tofijak/kestrel/docs/img/adapter_iPhone15_scope_side.png

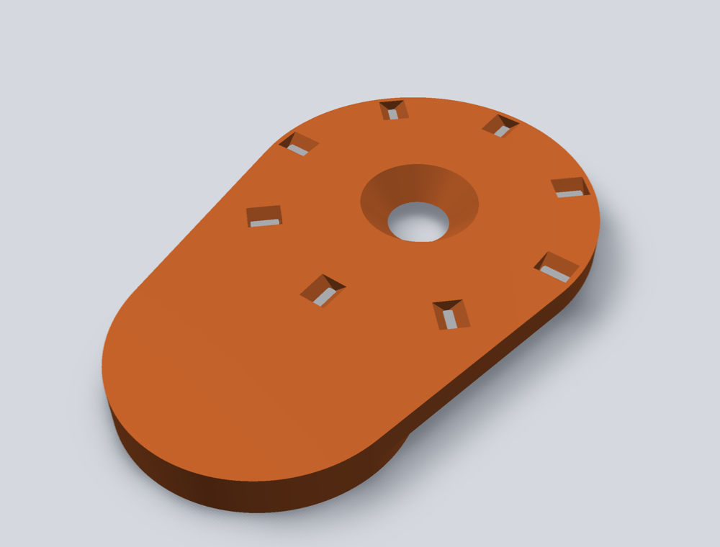
docs/img/adapter_iPhone15_scope_side.png
