tofijak/kestrel/preview.png

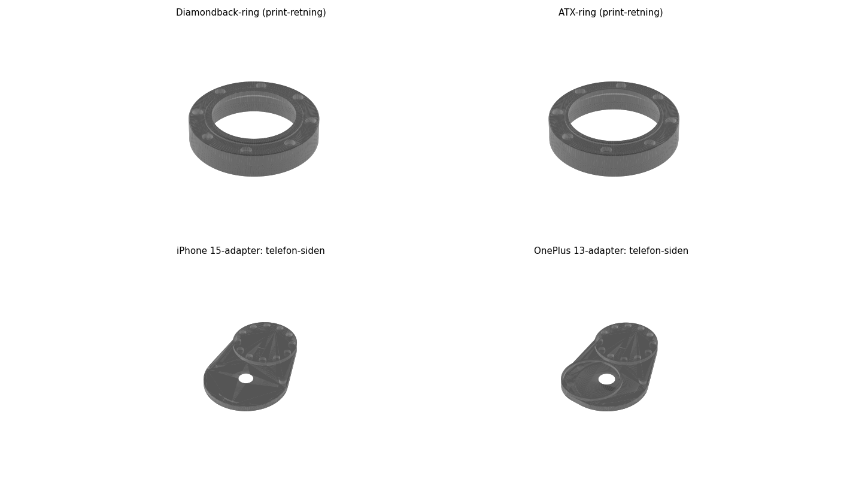
preview.png
