tofijak/kestrel/samling_OP13_preview.png

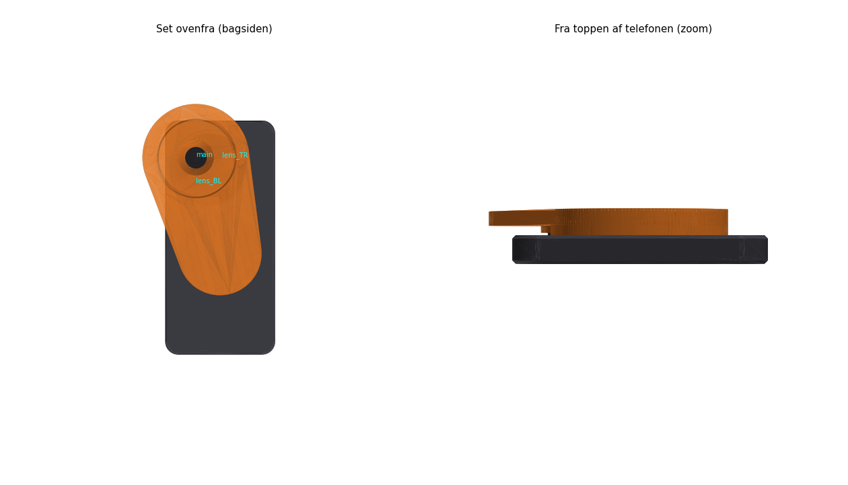
samling_OP13_preview.png
