tofijak/kestrel/print/PLA_Diamondback_iPhone15.3mf

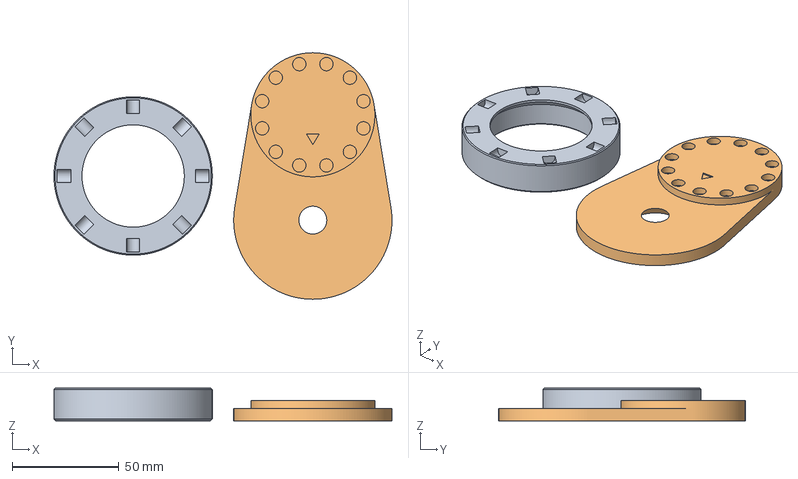
[picture p14: CAD file, 2026-11-11]
print/PLA_Diamondback_iPhone15.3mf
158.0 x 115.2 x 15.2 mm
okular_ring_DiamondbackHD85
telefon_adapter_iPhone15
