tofijak/kestrel/telefon_adapter_OP13.stl

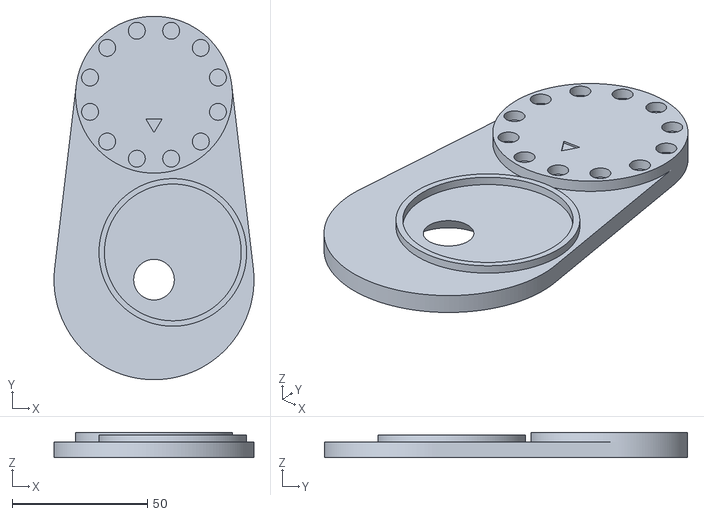
[picture p15: CAD file, 2026-11-11]
telefon_adapter_OP13.stl
74.0 x 134.4 x 9.30
