tofijak/kestrel/print/PETG_test_kobling.3mf

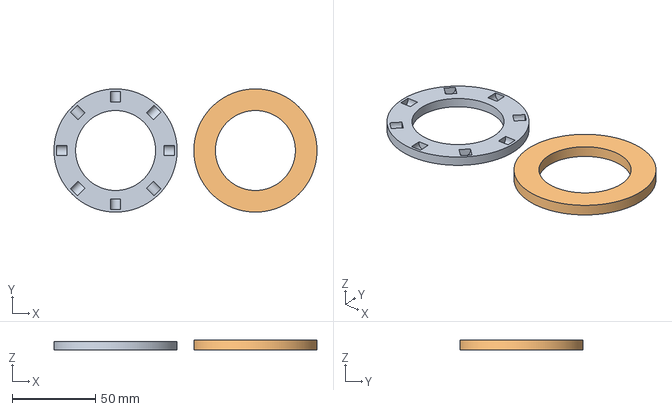
[picture p16: CAD file, 2026-11-11]
print/PETG_test_kobling.3mf
158.0 x 74.0 x 5.80 mm
test_ring
test_adapter
