tofijak/kestrel/test_ring.stl

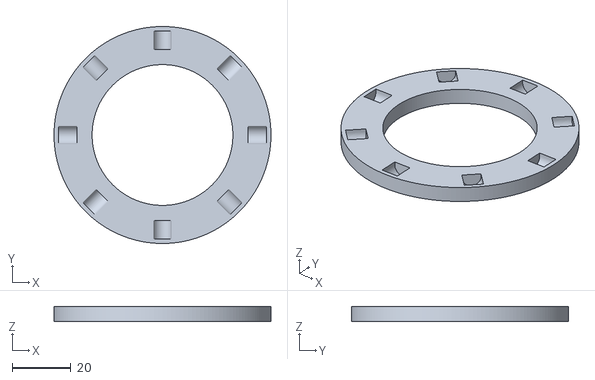
[picture p17: CAD file, 2026-11-11]
test_ring.stl
74.0 x 74.0 x 5.00
