tofijak/kestrel/okular_ring_ATX.stl

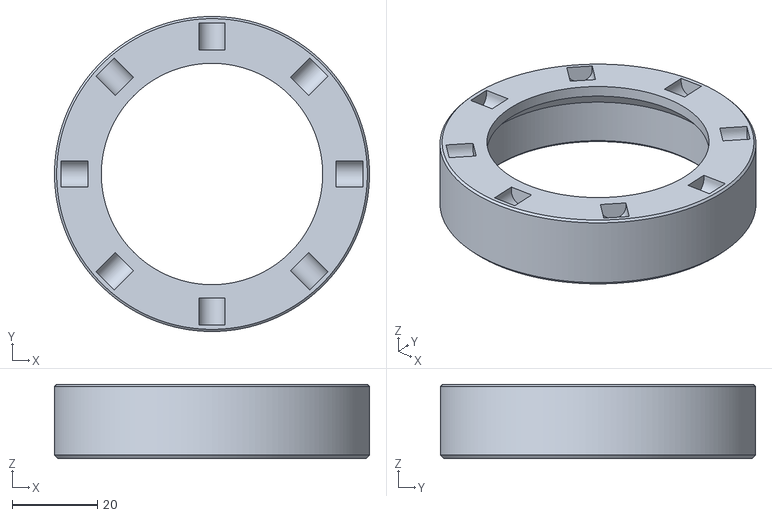
[picture p18: CAD file, 2026-11-11]
okular_ring_ATX.stl
74.0 x 74.0 x 17.5
