tofijak/kestrel/print/PLA_ATX_OnePlus13.3mf

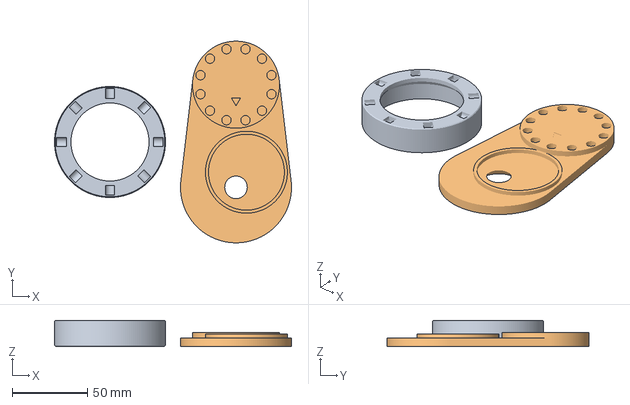
[picture p19: CAD file, 2026-11-11]
print/PLA_ATX_OnePlus13.3mf
158.0 x 134.4 x 17.5 mm
okular_ring_ATX
telefon_adapter_OP13
