tofijak/kestrel/test_adapter.stl

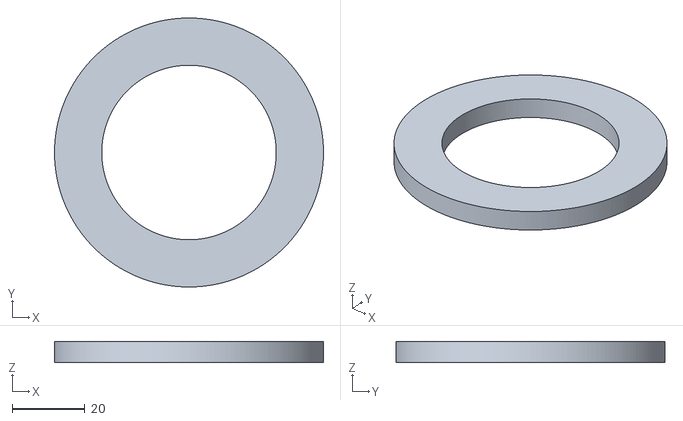
[picture p20: CAD file, 2026-11-11]
test_adapter.stl
74.0 x 74.0 x 5.80
