tofijak/kestrel/telefon_adapter_iPhone15.stl

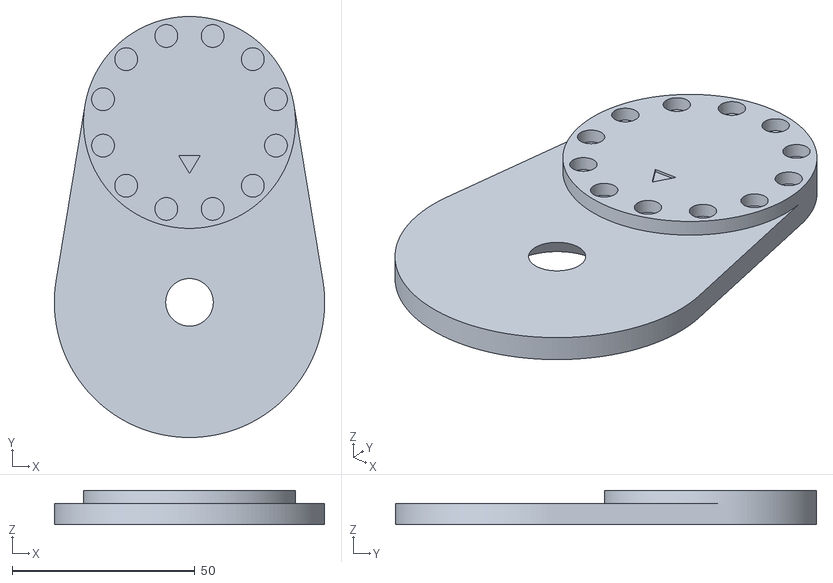
[picture p21: CAD file, 2026-11-11]
telefon_adapter_iPhone15.stl
74.0 x 115.2 x 9.40
