tofijak/kestrel/okular_ring_DiamondbackHD85.stl

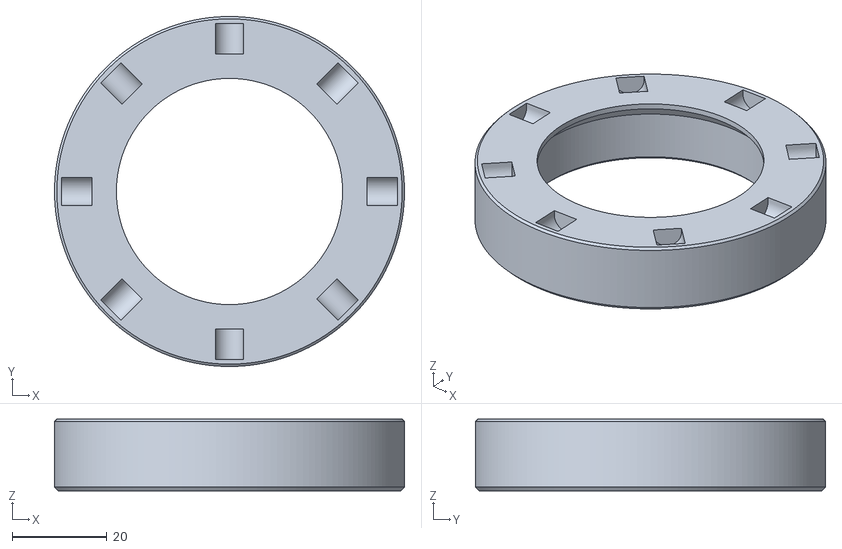
[picture p22: CAD file, 2026-11-11]
okular_ring_DiamondbackHD85.stl
74.0 x 74.0 x 15.2
