tofijak/kestrel/samling_OP13_adapter.stl

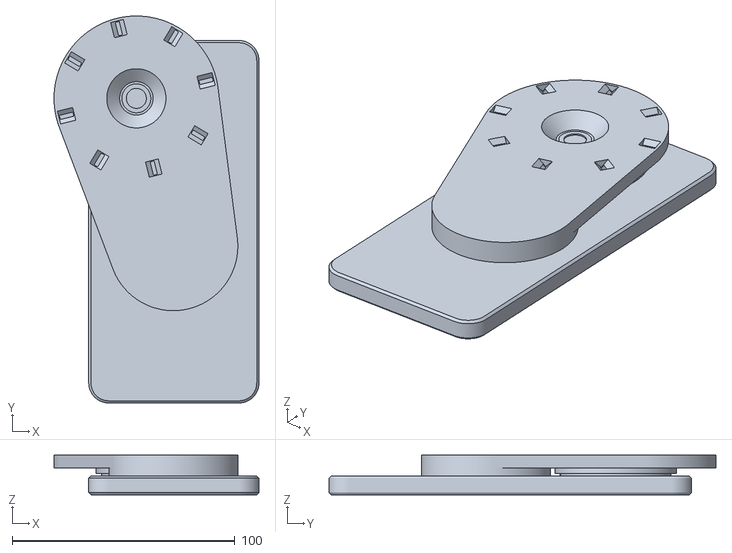
[picture p23: CAD file, 2026-11-11]
samling_OP13_adapter.stl
92.1 x 173.9 x 17.8
