tofijak/kestrel/oneplus13_model.stl

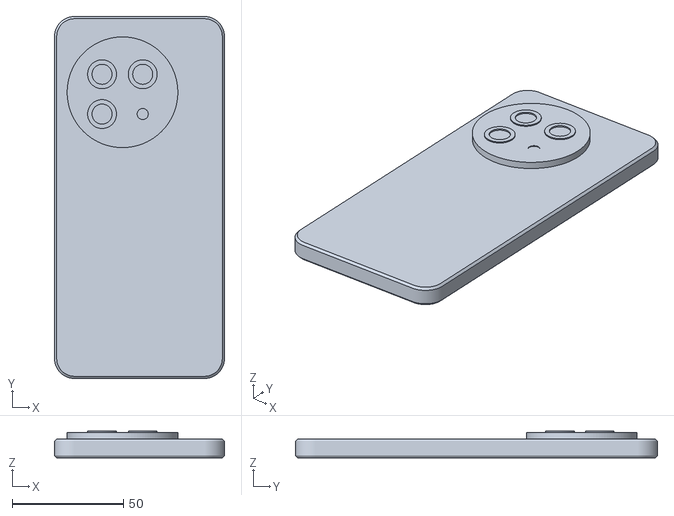
[picture p24: CAD file, 2026-11-10]
oneplus13_model.stl
76.5 x 162.9 x 12.0
