tofijak/kestrel/(list of files, cad)

Other CAD files:
print/PETG_kun_ring_ATX.3mf
print/PETG_Diamondback_iPhone15.3mf
print/PLA_kun_ring_ATX.3mf
print/PLA_test_kobling.3mf
print/PETG_ATX_OnePlus13.3mf
