tofijak/kestrel/(commit log)

2026-11-10 Magnetisk digiscoping-adapter: ringe, telefon-adaptere, printfiler og metode
    Okular-ringe (Swarovski ATX Ø59, Vortex Diamondback HD 85), telefon-adaptere
    (OnePlus 13 med krave, iPhone 15), PrusaSlicer-projekter til Prusa MINI og
    METODE.md med regler for mål og validering.
    [PETG_ATX_OnePlus13.3mf, PETG_Diamondback_iPhone15.3mf, PLA_ATX_OnePlus13.3mf, PLA_Diamondback_iPhone15.3mf, PLA_kun_ring_ATX.3mf, okular_ring_ATX.stl, okular_ring_DiamondbackHD85.stl, oneplus13_model.stl]
2026-11-10 Bedre printkvalitet: skrå søm, ingen tråde over magnetlommer, ironing
    - scarf seam (ingen lodret søm på ringene)
    - avoid crossing perimeters (ingen tråde/knopper over lommerne)
    - retraktion 3,2 mm @ 35 mm/s + wipe (Prusa MINI-standard)
    - ironing af øverste lag (MagSafe-puden), PLA 195 °C
    - ny plade med kun ATX-ringen, PETG-filer genbygget med Ø59-ringen
    [PETG_ATX_OnePlus13.3mf, PETG_Diamondback_iPhone15.3mf, PETG_kun_ring_ATX.3mf, PLA_ATX_OnePlus13.3mf, PLA_Diamondback_iPhone15.3mf, PLA_kun_ring_ATX.3mf]
2026-11-10 English README with renders, turntable and cutaway
    tools/render.py renders all README images from the same CAD as the STLs.
2026-11-10 Adapter: steel discs instead of magnets on the scope side
    Magnets stay in the ring only. Field at the phone camera drops from ~3.6 mT
    to ~1.6 mT when clicked on, and to ~0 when the adapter is off the scope.
    Disc size (Ø6 x 1 mm) is an estimate until real discs are measured.
    Rings are unchanged, so older magnet adapters still fit.
    [PETG_ATX_OnePlus13.3mf, PETG_Diamondback_iPhone15.3mf, PETG_kun_ring_ATX.3mf, PLA_ATX_OnePlus13.3mf, PLA_Diamondback_iPhone15.3mf, PLA_kun_ring_ATX.3mf, samling_OP13_adapter.stl, telefon_adapter_OP13.stl]
2026-11-10 Steel discs in the ring, magnets in the adapter
    Swaps the previous commit around: the eyepiece ring now holds 8 plain
    steel discs and the phone adapter carries the 8 scope-side magnets.
    No magnets on the optics; ~2 mT at the phone camera instead of 3.6 mT.
    ATX ring is 0.45 mm lower because the disc pockets are shallower.
    Disc size (Ø6 x 1 mm) is still an estimate until real discs are measured.
    [PETG_ATX_OnePlus13.3mf, PETG_Diamondback_iPhone15.3mf, PETG_kun_ring_ATX.3mf, PLA_ATX_OnePlus13.3mf, PLA_Diamondback_iPhone15.3mf, PLA_kun_ring_ATX.3mf, okular_ring_ATX.stl, okular_ring_DiamondbackHD85.stl]
2026-11-10 Ring steel: Ø6 x 3 mm GB119 dowel pins instead of Ø6 x 1 discs
    Ø6 iron discs are hard to find; bearing-steel dowel pins M6x3 are cheap
    (AliExpress, 50 pcs) and the same size as the magnets. Disc pockets and
    ring height follow; ATX ring is back to 18.0 mm. All fit checks pass.
    [PETG_ATX_OnePlus13.3mf, PETG_Diamondback_iPhone15.3mf, PETG_kun_ring_ATX.3mf, PLA_ATX_OnePlus13.3mf, PLA_Diamondback_iPhone15.3mf, PLA_kun_ring_ATX.3mf, okular_ring_ATX.stl, okular_ring_DiamondbackHD85.stl]
2026-11-10 Ring steel: M6 x 6 mm pins (Ø6 pins don't come shorter)
    M6 x 3-5 dowel pins are sold out / non-standard. With 6 mm pins the
    ATX ring is 21.0 mm (+3) and the Diamondback ring 18.05 mm (+1.35).
    All fit checks pass; print files and renders rebuilt.
    [PETG_ATX_OnePlus13.3mf, PETG_Diamondback_iPhone15.3mf, PETG_kun_ring_ATX.3mf, PLA_ATX_OnePlus13.3mf, PLA_Diamondback_iPhone15.3mf, PLA_kun_ring_ATX.3mf, okular_ring_ATX.stl, okular_ring_DiamondbackHD85.stl]
2026-11-10 Print files: ironing off by default for fit-test prints
    IRON=1 ./build_print.sh turns top-most ironing back on (+25 min) once
    the fit is confirmed. ATX + OnePlus 13 plate: 3 h 55 min.
    [PETG_ATX_OnePlus13.3mf, PETG_Diamondback_iPhone15.3mf, PETG_kun_ring_ATX.3mf, PLA_ATX_OnePlus13.3mf, PLA_Diamondback_iPhone15.3mf, PLA_kun_ring_ATX.3mf]
2026-11-11 Coupling v2: three steel balls in radial V-grooves
    Replaces the centring lip and the 8 steel pins with a kinematic coupling:
    3 x Ø6 chrome-steel balls in the ring (120°), 12 radial 90° V-grooves in
    the adapter (every 30°, so portrait and landscape both work). A 6x3 magnet
    is sealed 0.3 mm above each groove; the print pauses at 5.4 mm to drop
    them in. Locks rotation and centring; rings get 3-4 mm lower.
    - coupling = "balls" | "lip" (v1 geometry kept)
    - test_ring / test_adapter + print/*_test_kobling for a quick hold test
    - build_print.sh writes the M601 pause into adapter plates
    - README, METODE and renders updated
    [PETG_ATX_OnePlus13.3mf, PETG_Diamondback_iPhone15.3mf, PETG_kun_ring_ATX.3mf, PETG_test_kobling.3mf, PLA_ATX_OnePlus13.3mf, PLA_Diamondback_iPhone15.3mf, PLA_kun_ring_ATX.3mf, PLA_test_kobling.3mf]
2026-11-11 Coupling v2: lying M6x6 pins instead of balls (default)
    A Ø6 pin lying radially in the V-groove has the same cross-section as a
    Ø6 ball (two contact lines at 45°), so the adapter is unchanged and the
    M6x6 pins already bought can be used. ball_shape = "ball" keeps balls.
    [PETG_ATX_OnePlus13.3mf, PETG_Diamondback_iPhone15.3mf, PETG_kun_ring_ATX.3mf, PETG_test_kobling.3mf, PLA_ATX_OnePlus13.3mf, PLA_Diamondback_iPhone15.3mf, PLA_kun_ring_ATX.3mf, PLA_test_kobling.3mf]
2026-11-11 Docs: pin wording
2026-11-11 Coupling v2: 8 pins in 8 grooves, one pin under every magnet
    Same steel and magnet count as v1 (8 + 8), so every magnet pulls on its
    own pin. 45° steps keep portrait/landscape. 20 magnets per adapter again.
    [PETG_ATX_OnePlus13.3mf, PETG_Diamondback_iPhone15.3mf, PETG_kun_ring_ATX.3mf, PETG_test_kobling.3mf, PLA_ATX_OnePlus13.3mf, PLA_Diamondback_iPhone15.3mf, PLA_kun_ring_ATX.3mf, PLA_test_kobling.3mf]
